devlinih/PIE-MP3/README.md

# PIE Mini Project 3: Line Follower

Devlin Ih, Kat Canavan, William Skelly

# Notes

***Requires Python 3.10 or newer***. [PEP 636](https://peps.python.org/pep-0636/) is
just too nice. As of October 2022, this is newer than many Linux distributions.
