devlinih/PIE-MP3/Pictures/BangBang.png

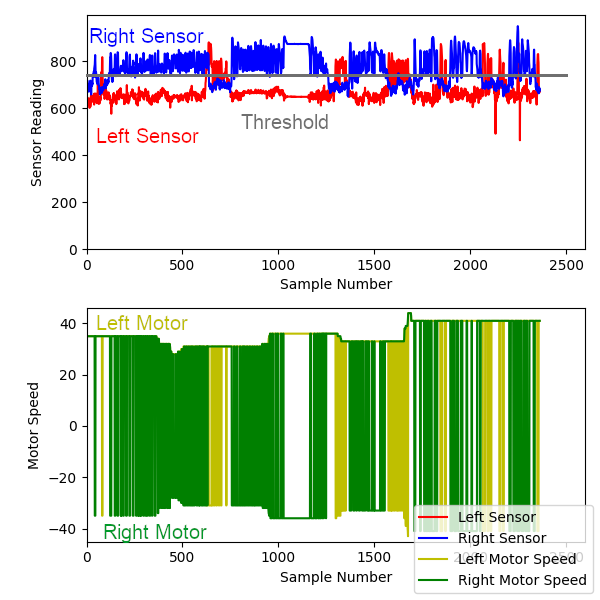
Pictures/BangBang.png
