devlinih/PIE-MP3/Hardware/Car_Assem.SLDASM

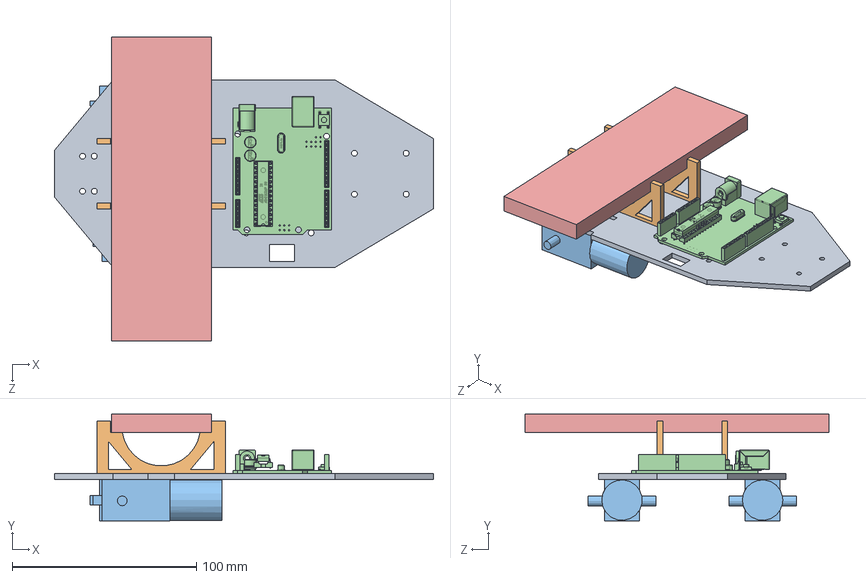
[picture p5: CAD file, 2022-10-07]
Hardware/Car_Assem.SLDASM
205.7 x 58.0 x 165.0 mm
Base Plate
BreadShelf x 2
Motor Simple x 2
Simple arduino uno
Breadboard
