devlinih/PIE-MP3/Hardware/Standoff.SLDPRT

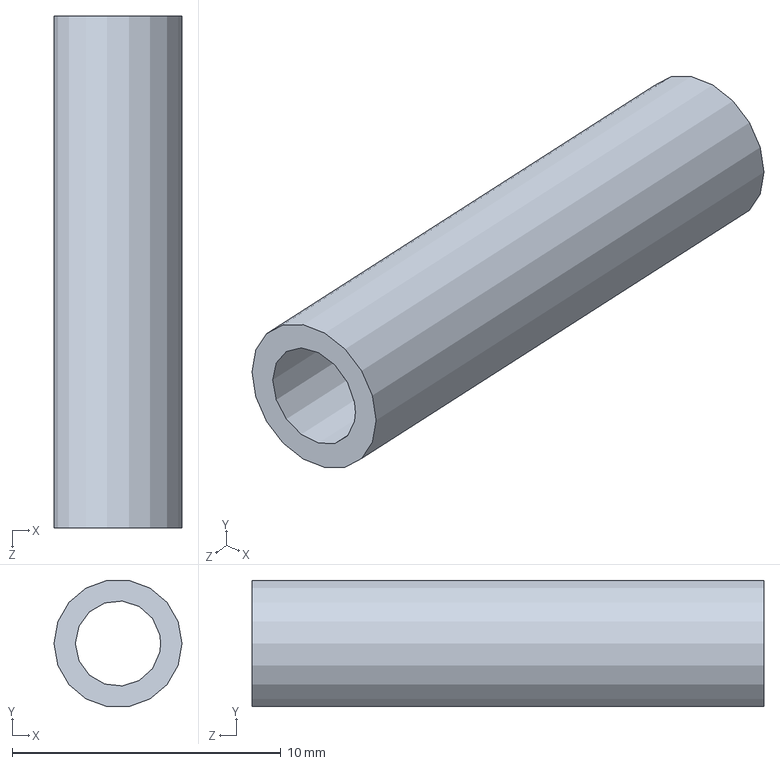
[picture p6: CAD file, 2022-10-13]
Hardware/Standoff.SLDPRT
4.76 x 4.69 x 19.1 mm
