devlinih/PIE-MP3/Hardware/BreadShelf.SLDPRT

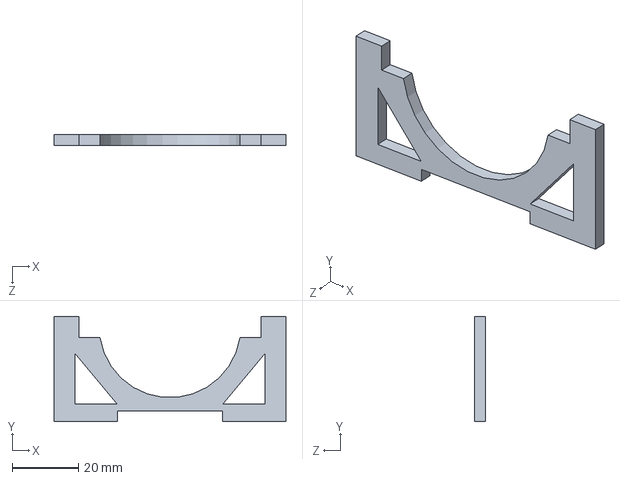
[picture p7: CAD file, 2022-10-07]
Hardware/BreadShelf.SLDPRT
69.8 x 31.8 x 3.17 mm
