devlinih/PIE-MP3/Hardware/Simple arduino uno.SLDPRT

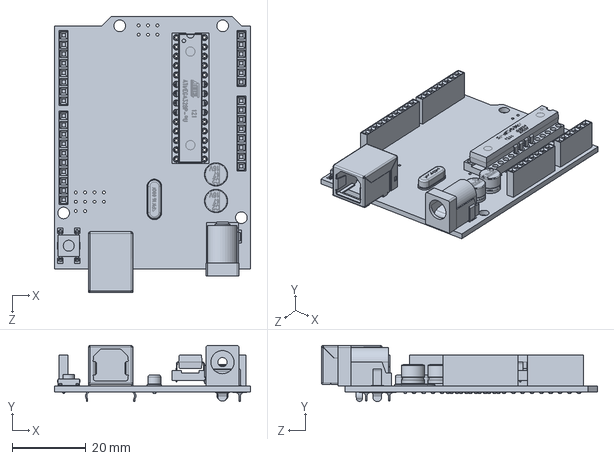
[picture p8: CAD file, 2022-10-07]
Hardware/Simple arduino uno.SLDPRT
53.3 x 15.2 x 74.9 mm
