devlinih/PIE-MP3/Hardware/Sensor Mount.SLDPRT

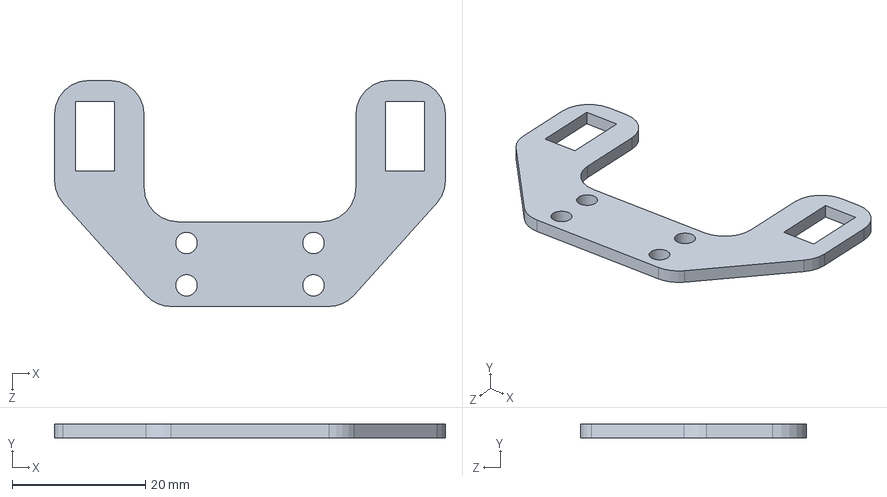
[picture p9: CAD file, 2022-10-07]
Hardware/Sensor Mount.SLDPRT
58.6 x 2.03 x 33.9 mm
