devlinih/PIE-MP3/Hardware/Base Plate.SLDPRT

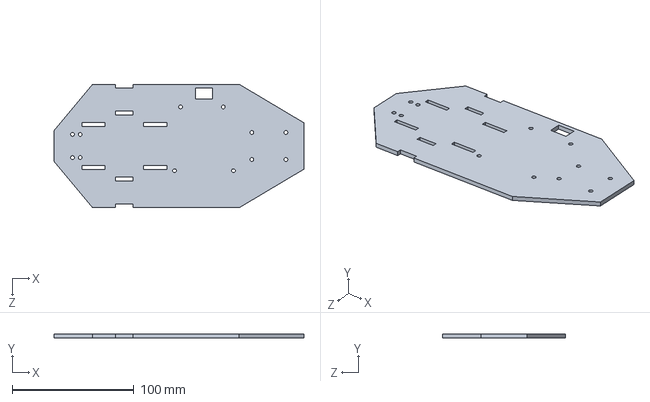
[picture p10: CAD file, 2022-10-07]
Hardware/Base Plate.SLDPRT
205.7 x 3.17 x 101.6 mm
