devlinih/PIE-MP3/Hardware/Motor Simple.SLDPRT

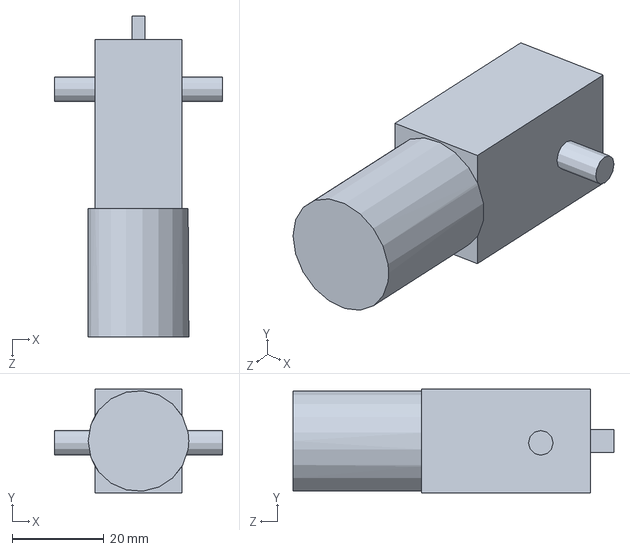
[picture p11: CAD file, 2022-10-07]
Hardware/Motor Simple.SLDPRT
36.7 x 22.6 x 70.1 mm
