devlinih/PIE-MP3/Hardware/Breadboard.SLDPRT

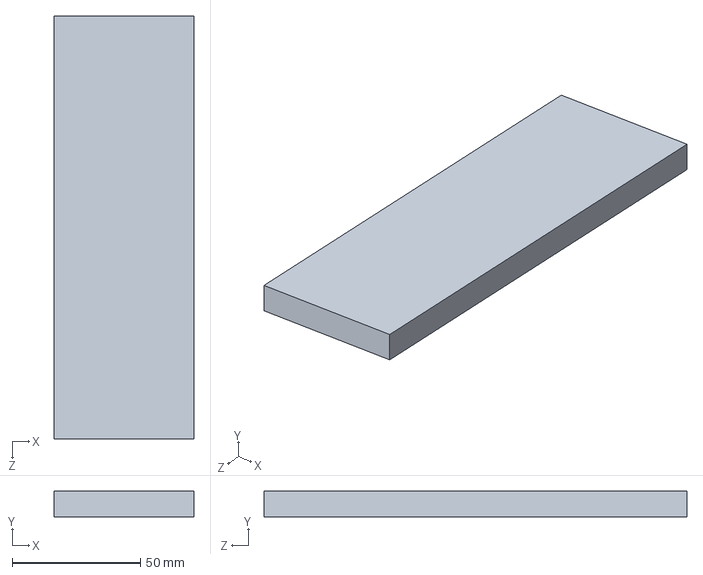
[picture p12: CAD file, 2022-10-07]
Hardware/Breadboard.SLDPRT
54.5 x 10.0 x 165.0 mm
