devlinih/PIE-MP3/(list of files, cad)

Other CAD files:
Hardware/Car Cut Sheet.SLDDRW
Hardware/Sensor Mount.STL
Hardware/Standoff.STL
