devlinih/PIE-MP3/(commit log)

2022-10-02 Add code to interface with Arduino through Python scripts
2022-10-03 Fix format for Devlin
    [LineRobotFirmware.ino]
2022-10-04 Parse tuples from Arduino
2022-10-04 Comment out START message from start of Arduino
2022-10-07 Add threading template
2022-10-07 More CAD :)
    [Base Plate.SLDPRT, BreadShelf.SLDPRT, Breadboard.SLDPRT, Car Cut Sheet.SLDDRW, Car_Assem.SLDASM, Motor Simple.SLDPRT, Sensor Mount.SLDPRT, Sensor Mount.STL]
2022-10-07 Fix a thing where strings were not turned to ints.
    [robot_gui.py]
2022-10-07 Actually init motor shield
2022-10-07 Visualize sensor data
2022-10-07 Fix line anti-follower bug (hopefully)
    Also, autopep8
    [control_loop.py, robot_gui.py]
2022-10-07 Actually make data update in GUI
    There is still a minor bug where robot has to be running for this to work. This
    has to due with the getting of the data requiring the loop to be running.
    [robot_gui.py]
2022-10-13 Made folder and added standoffs
    [Base Plate.SLDPRT, BreadShelf.SLDPRT, Breadboard.SLDPRT, Car Cut Sheet.SLDDRW, Car_Assem.SLDASM, Motor Simple.SLDPRT, Sensor Mount.SLDPRT, Sensor Mount.STL]
2022-10-13 Fix the typos that flipped left and right
    [control_loop.py]
2022-10-14 Real time plotting of motor speeds and sensor data!
2022-10-14 Add Mechanical CAD screenshot
